LemonExplosive/Light-Materials-Test-Rig/LMTRPhotos/20240612_171728.jpg

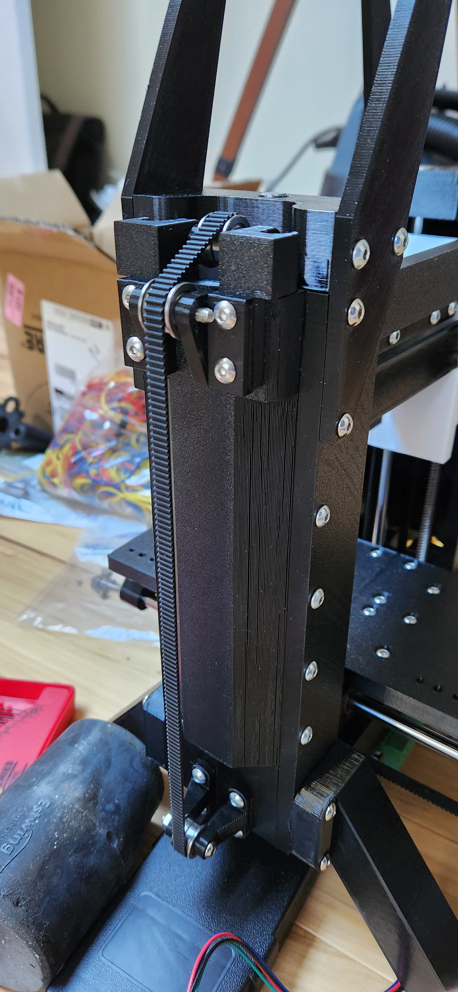
LMTRPhotos/20240612_171728.jpg
