LemonExplosive/Light-Materials-Test-Rig/LMTRPhotos/20240923_194150.jpg

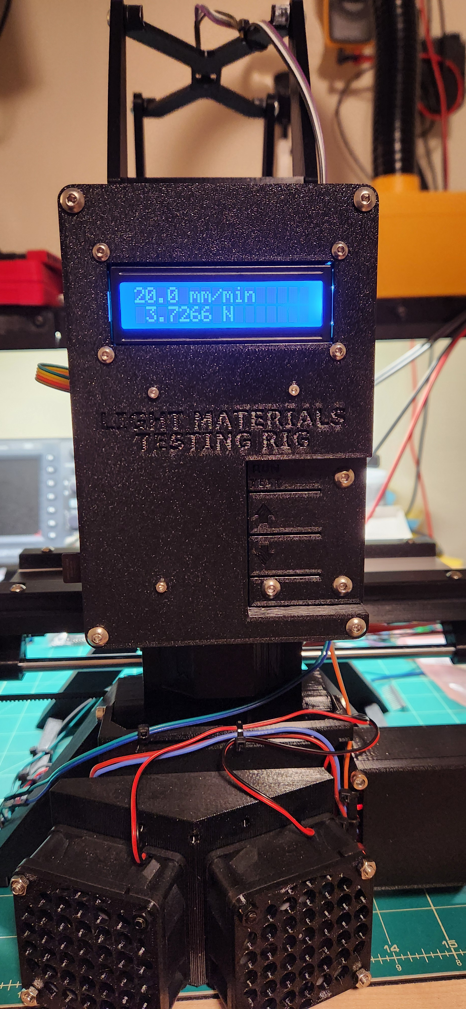
LMTRPhotos/20240923_194150.jpg
