LemonExplosive/Light-Materials-Test-Rig/LMTRPhotos/20240528_114817.jpg

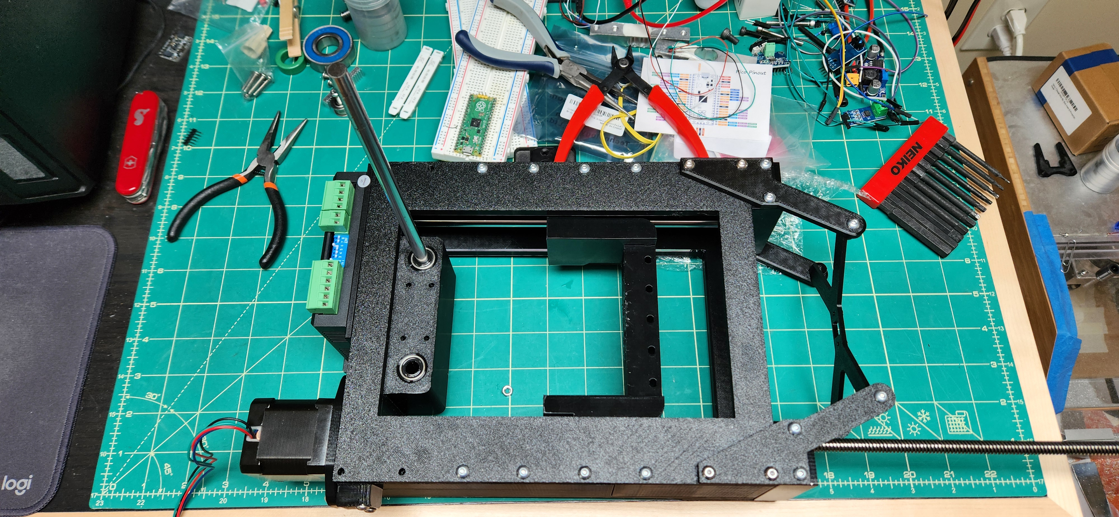
LMTRPhotos/20240528_114817.jpg
