LemonExplosive/Light-Materials-Test-Rig/LMTRPhotos/20240528_114821.jpg

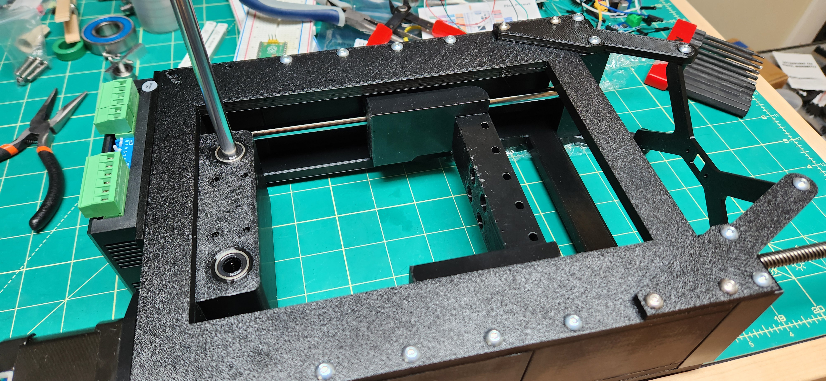
LMTRPhotos/20240528_114821.jpg
