LemonExplosive/Light-Materials-Test-Rig/LMTRPhotos/20240528_114832.jpg

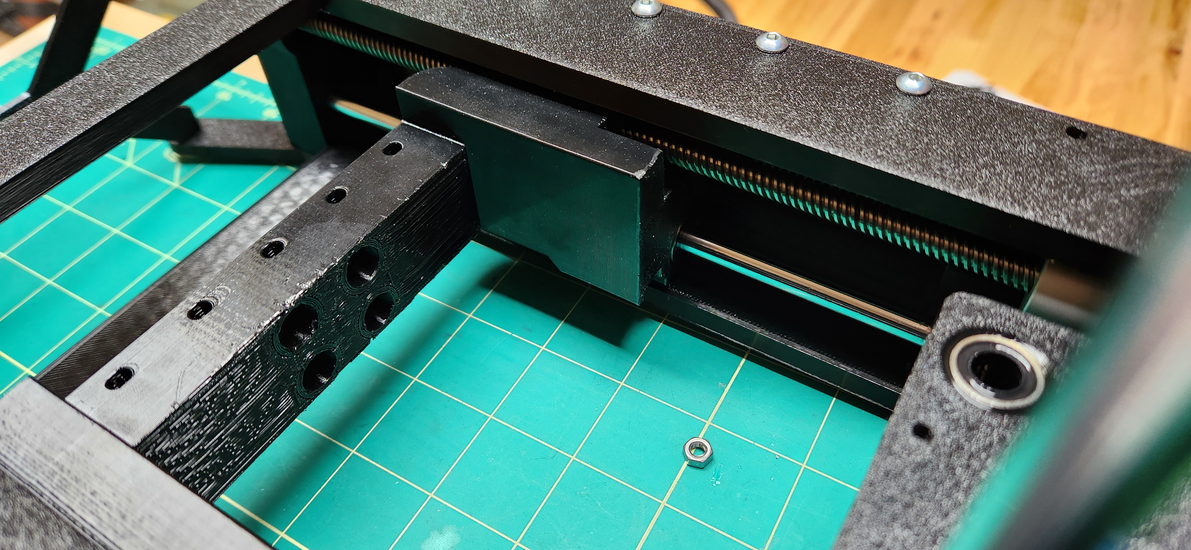
LMTRPhotos/20240528_114832.jpg
