LemonExplosive/Light-Materials-Test-Rig/LMTRPhotos/20240528_114836.jpg

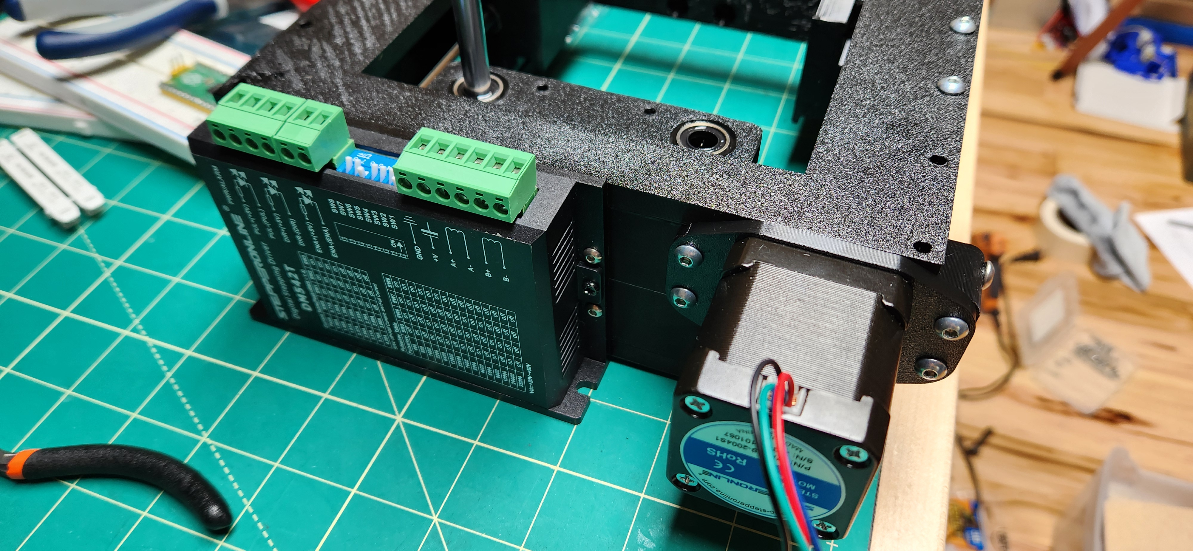
LMTRPhotos/20240528_114836.jpg
