LemonExplosive/Light-Materials-Test-Rig/LMTRPhotos/20240528_114841.jpg

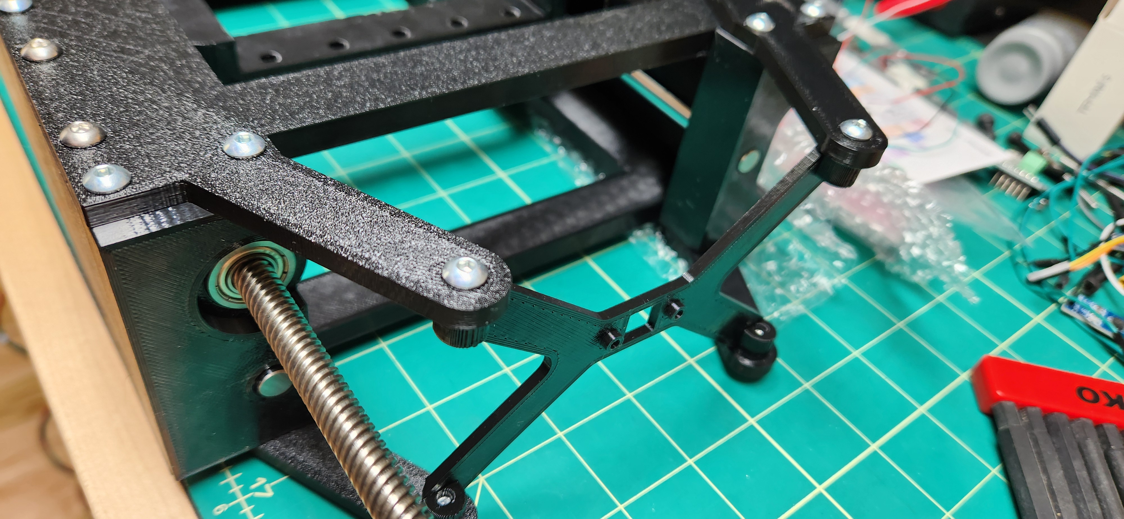
LMTRPhotos/20240528_114841.jpg
