LemonExplosive/Light-Materials-Test-Rig/LMTRPhotos/20240529_230357.jpg

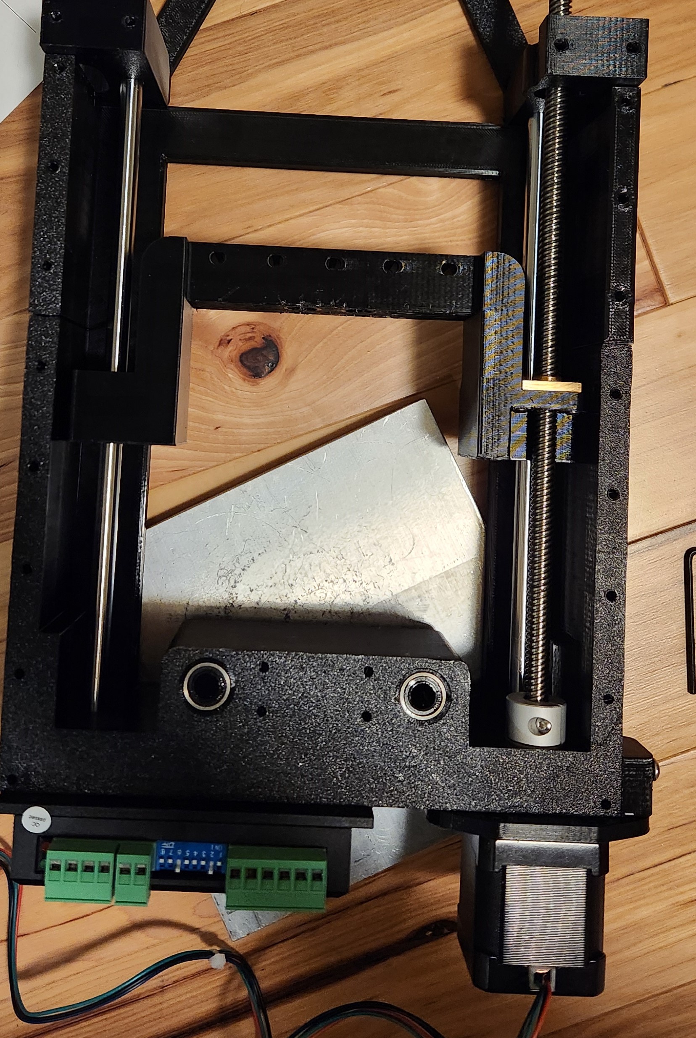
LMTRPhotos/20240529_230357.jpg
