LemonExplosive/Light-Materials-Test-Rig/LMTRPhotos/20240530_120917.jpg

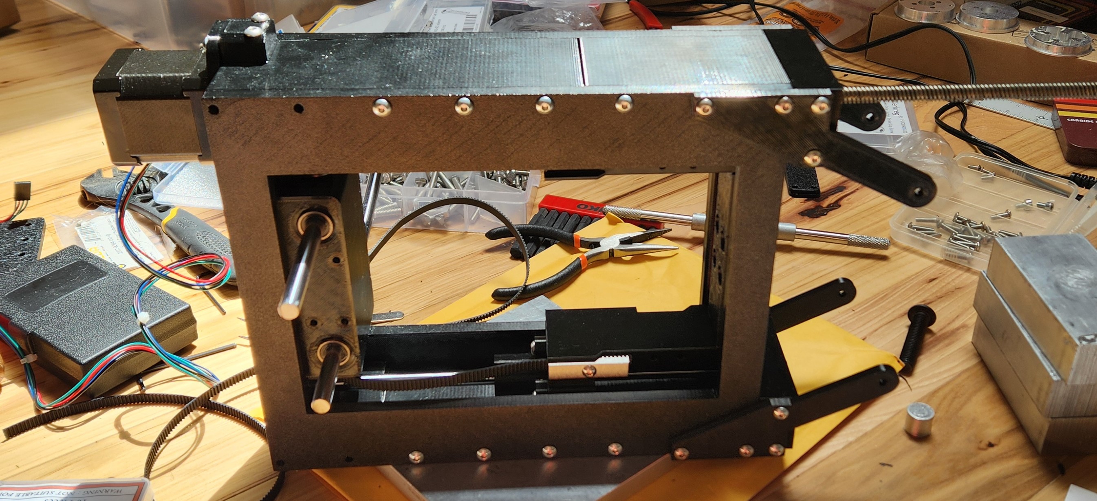
LMTRPhotos/20240530_120917.jpg
