LemonExplosive/Light-Materials-Test-Rig/LMTRPhotos/20240601_184201.jpg

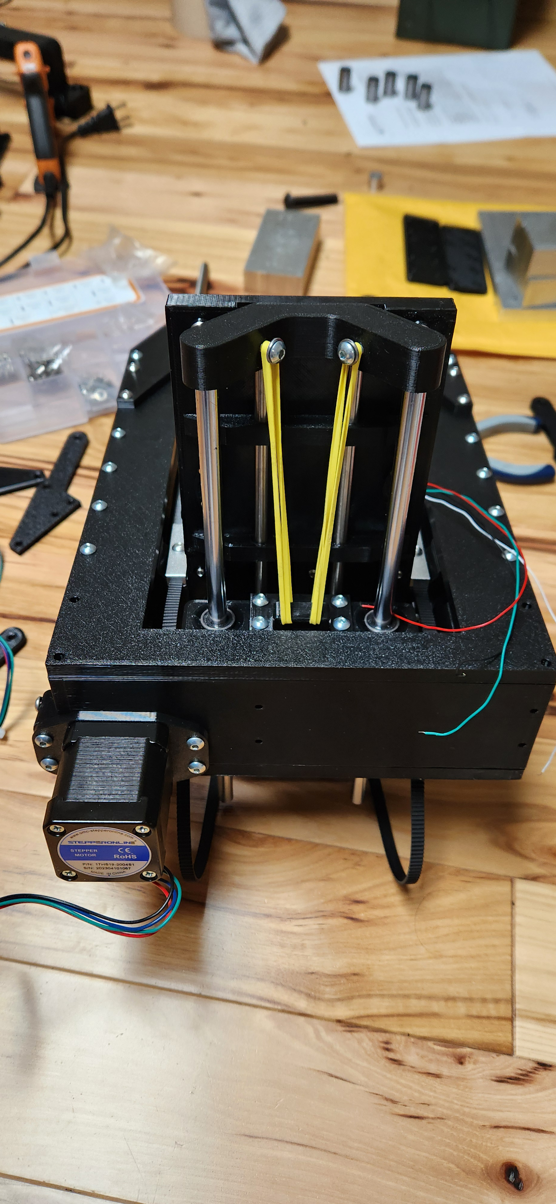
LMTRPhotos/20240601_184201.jpg
