LemonExplosive/Light-Materials-Test-Rig/LMTRPhotos/20240601_184204.jpg

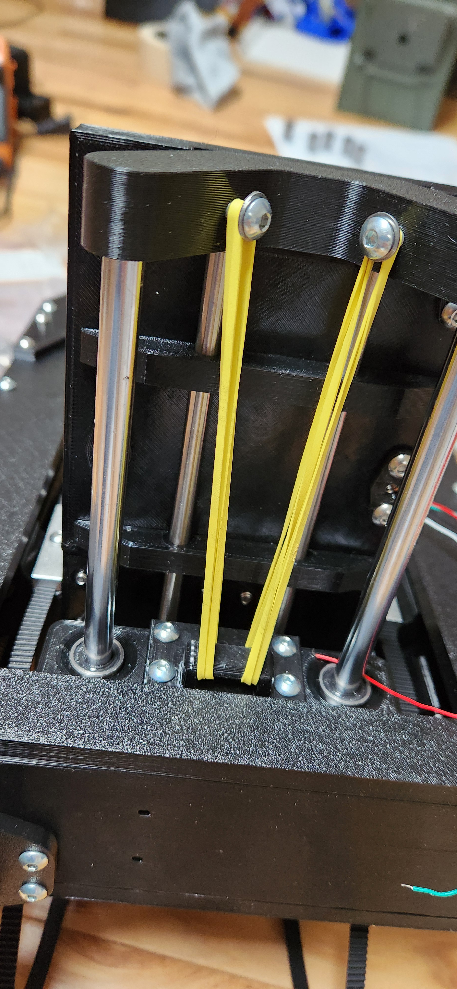
LMTRPhotos/20240601_184204.jpg
