LemonExplosive/Light-Materials-Test-Rig/LMTRPhotos/20240601_184206.jpg

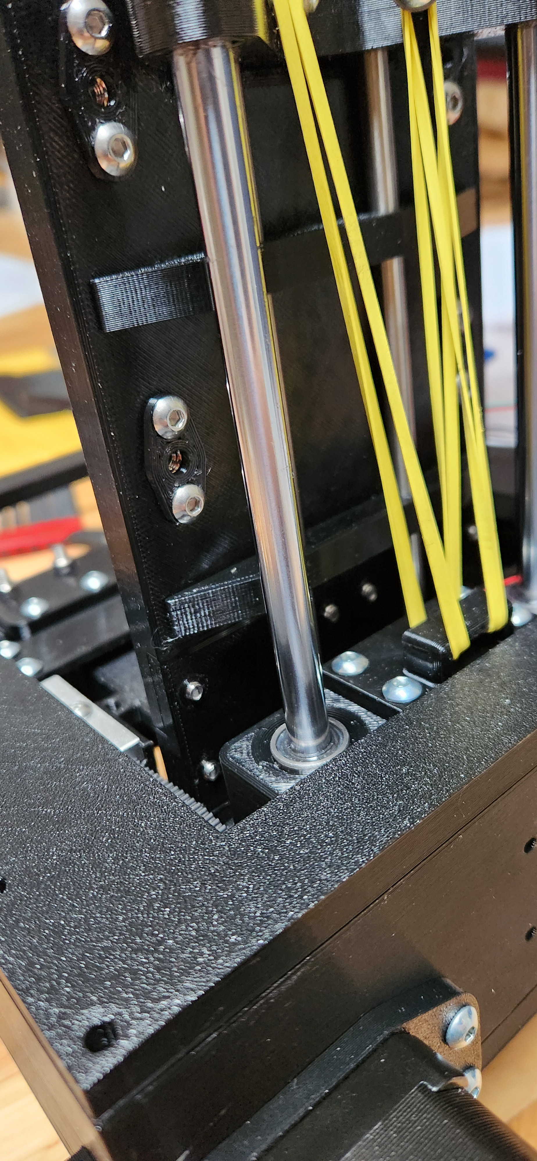
LMTRPhotos/20240601_184206.jpg
