LemonExplosive/Light-Materials-Test-Rig/LMTRPhotos/20240612_171720.jpg

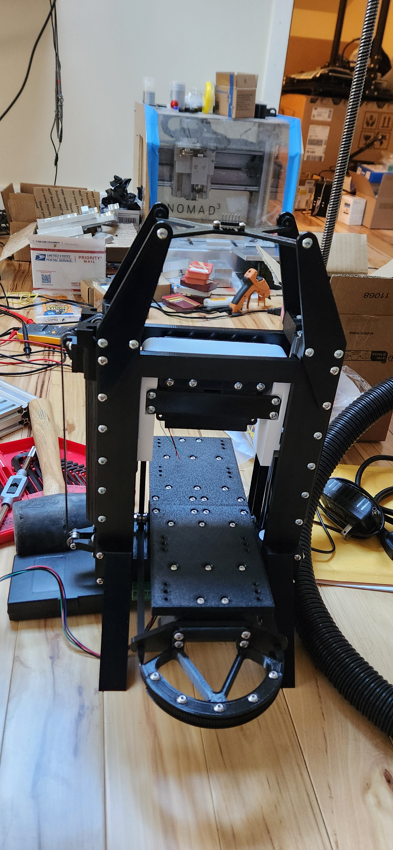
LMTRPhotos/20240612_171720.jpg
