LemonExplosive/Light-Materials-Test-Rig/LMTRPhotos/20240612_171732.jpg

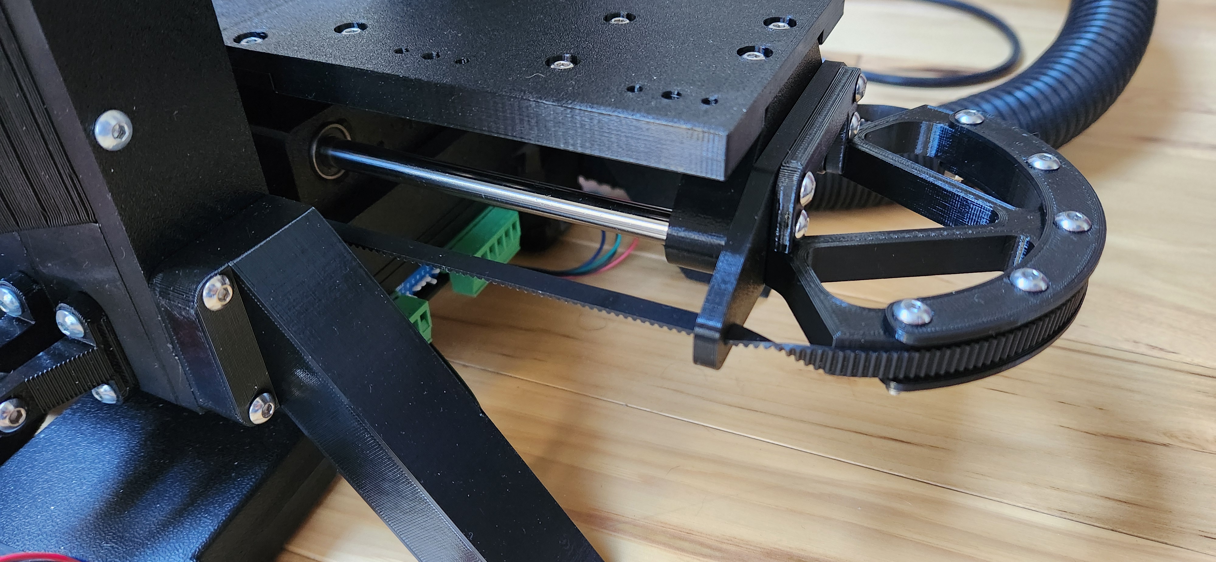
LMTRPhotos/20240612_171732.jpg
