LemonExplosive/Light-Materials-Test-Rig/LMTRPhotos/20240612_171736.jpg

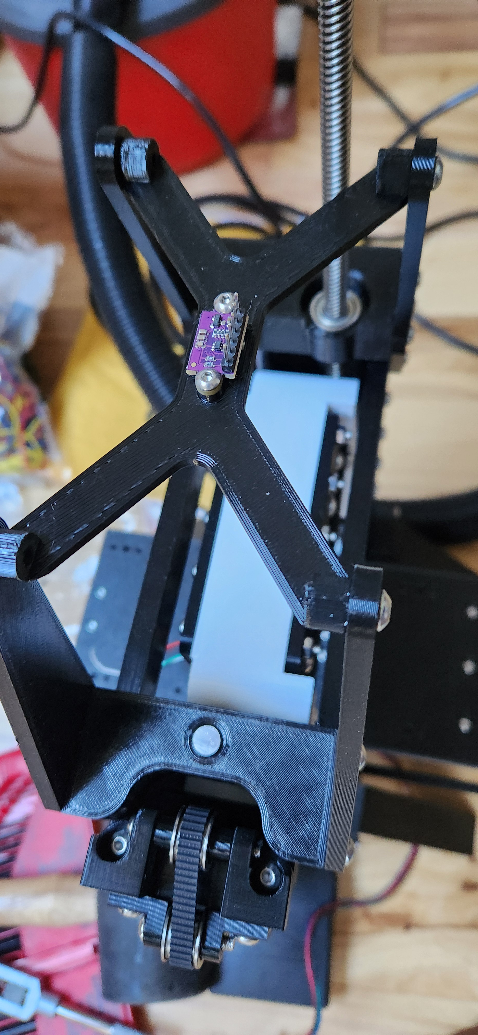
LMTRPhotos/20240612_171736.jpg
