LemonExplosive/Light-Materials-Test-Rig/LMTRPhotos/20240612_171740.jpg

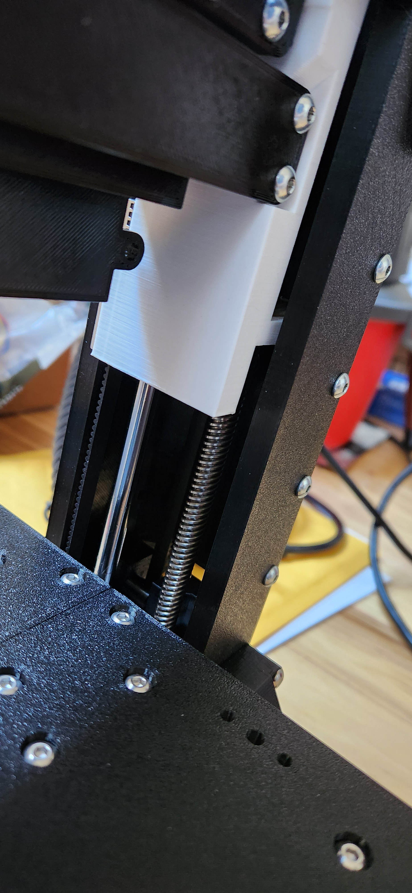
LMTRPhotos/20240612_171740.jpg
