LemonExplosive/Light-Materials-Test-Rig/LMTRPhotos/20240612_171745.jpg

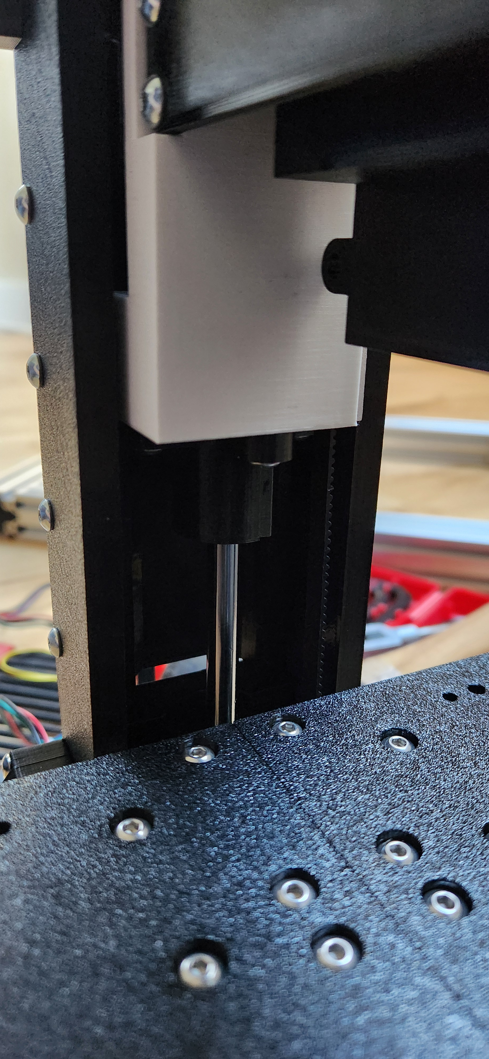
LMTRPhotos/20240612_171745.jpg
