LemonExplosive/Light-Materials-Test-Rig/LMTRPhotos/20240612_171805.jpg

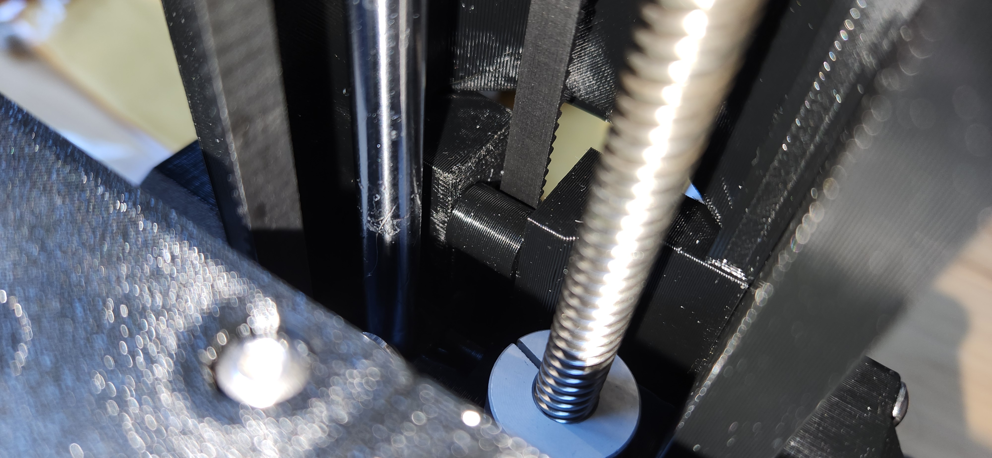
LMTRPhotos/20240612_171805.jpg
