LemonExplosive/Light-Materials-Test-Rig/LMTRPhotos/20240612_175203.jpg

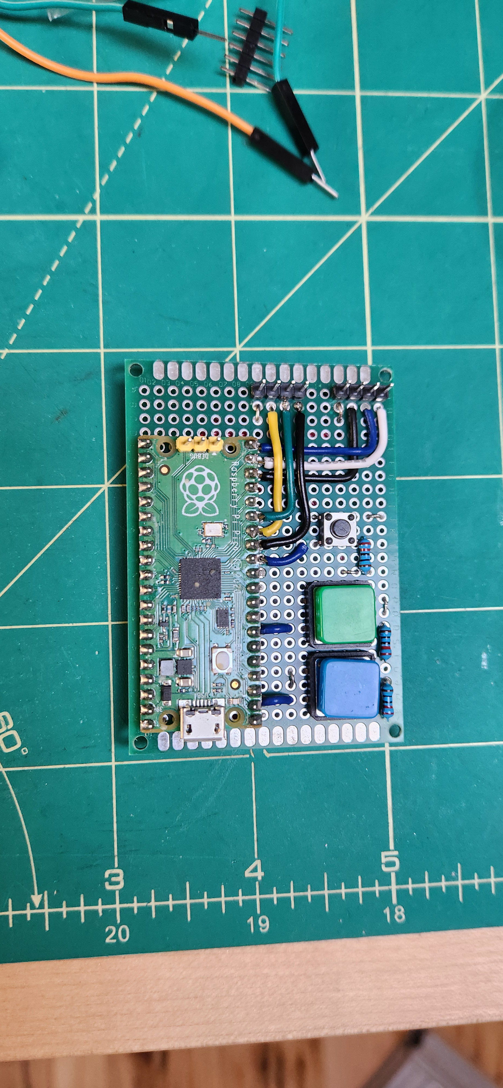
LMTRPhotos/20240612_175203.jpg
