LemonExplosive/Light-Materials-Test-Rig/LMTRPhotos/20240612_175207.jpg

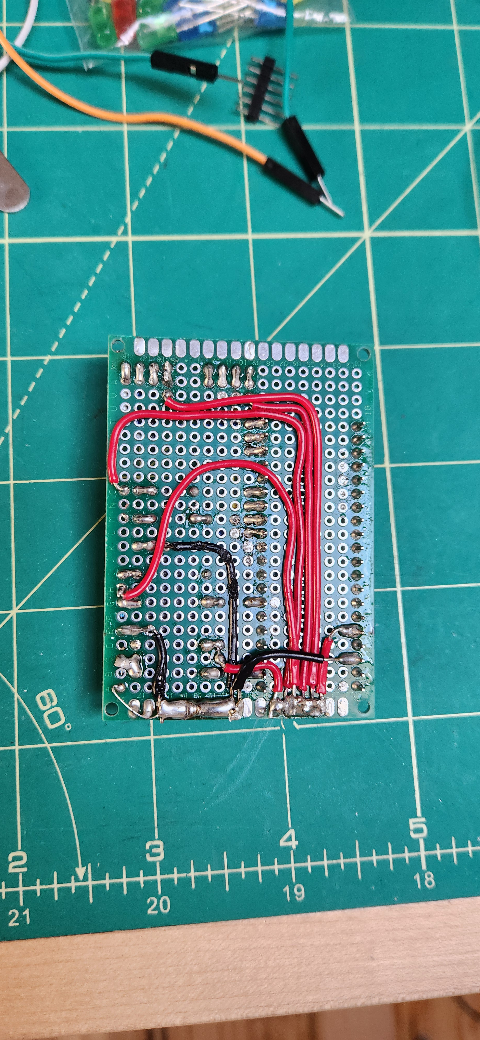
LMTRPhotos/20240612_175207.jpg
