LemonExplosive/Light-Materials-Test-Rig/LMTRPhotos/20240701_200305.jpg

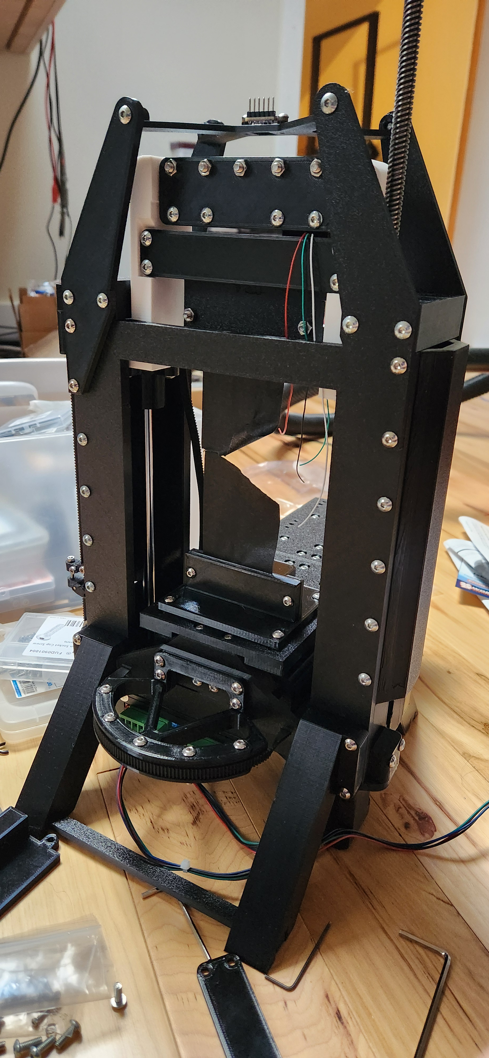
LMTRPhotos/20240701_200305.jpg
