LemonExplosive/Light-Materials-Test-Rig/LMTRPhotos/20240709_172404.jpg

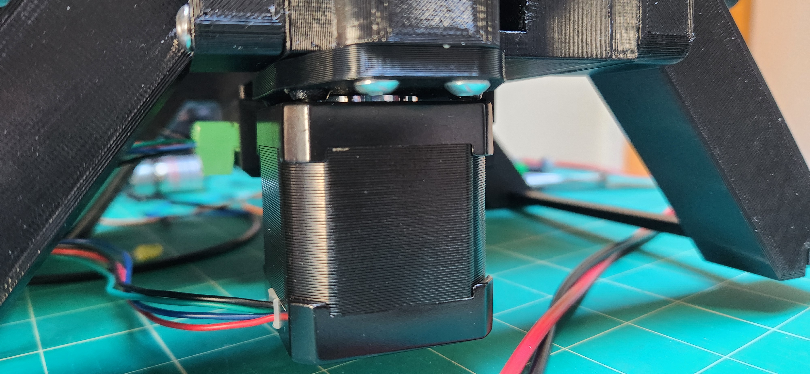
LMTRPhotos/20240709_172404.jpg
