LemonExplosive/Light-Materials-Test-Rig/LMTRPhotos/20240709_172408.jpg

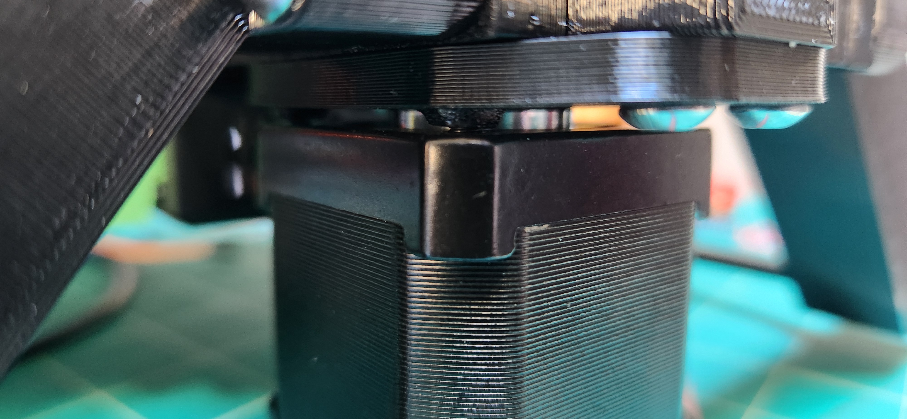
LMTRPhotos/20240709_172408.jpg
