LemonExplosive/Light-Materials-Test-Rig/LMTRPhotos/20240717_140434.jpg

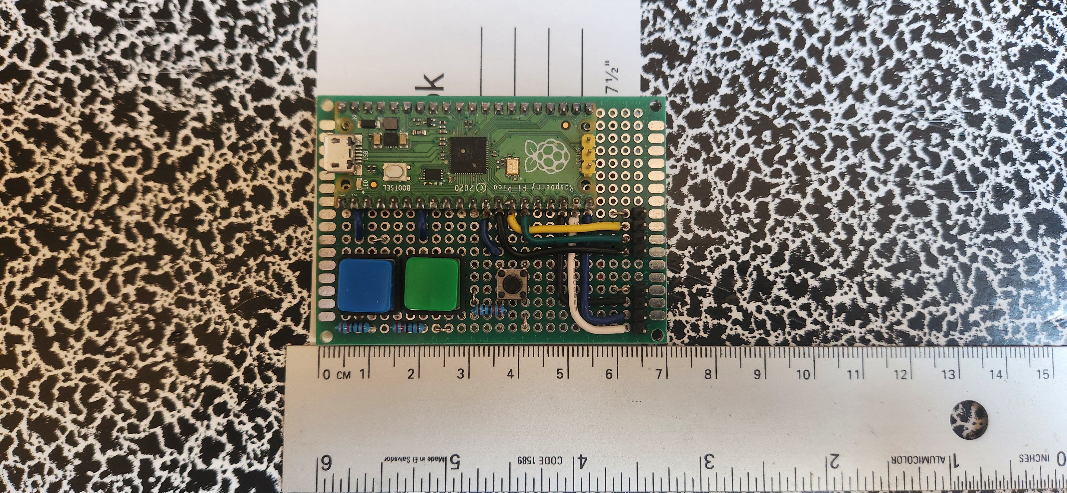
LMTRPhotos/20240717_140434.jpg
