LemonExplosive/Light-Materials-Test-Rig/LMTRPhotos/20240804_115958.jpg

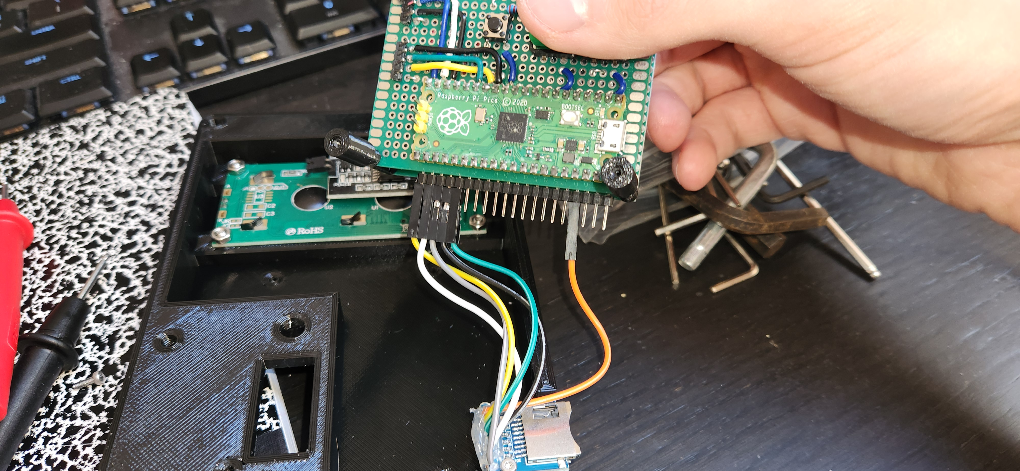
LMTRPhotos/20240804_115958.jpg
