LemonExplosive/Light-Materials-Test-Rig/LMTRPhotos/20240804_122026.jpg

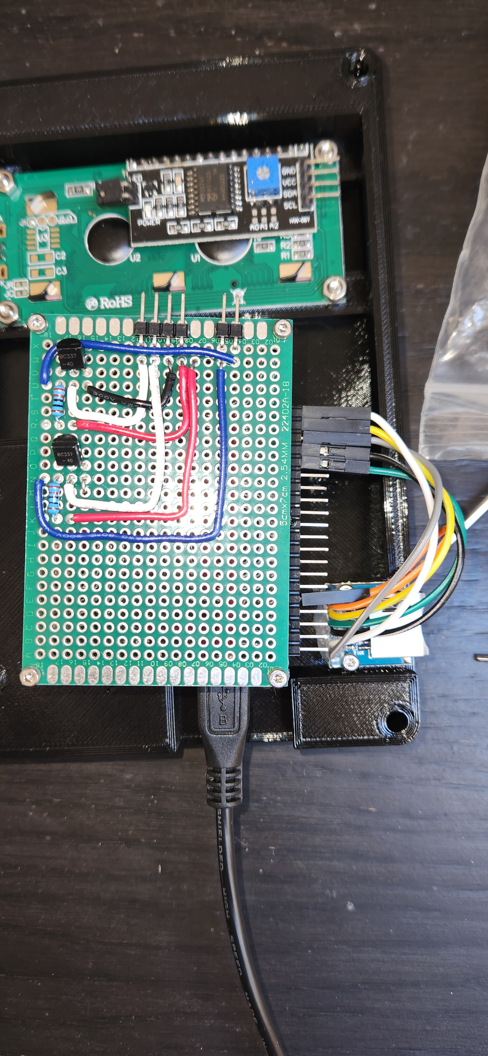
LMTRPhotos/20240804_122026.jpg
