LemonExplosive/Light-Materials-Test-Rig/LMTRPhotos/20240804_124502.jpg

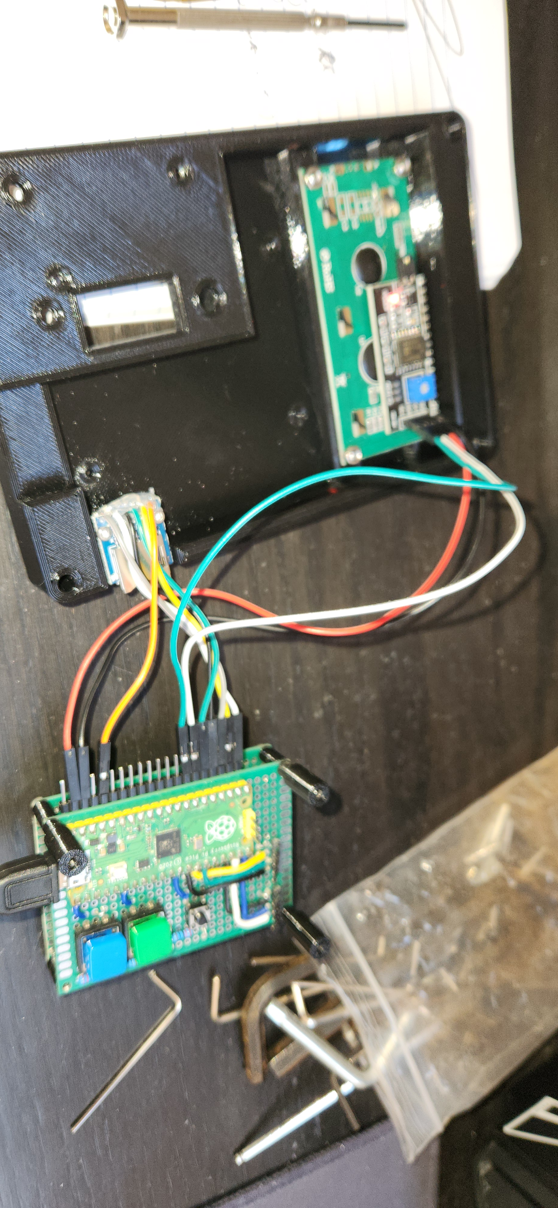
LMTRPhotos/20240804_124502.jpg
