LemonExplosive/Light-Materials-Test-Rig/LMTRPhotos/20240804_124520.jpg

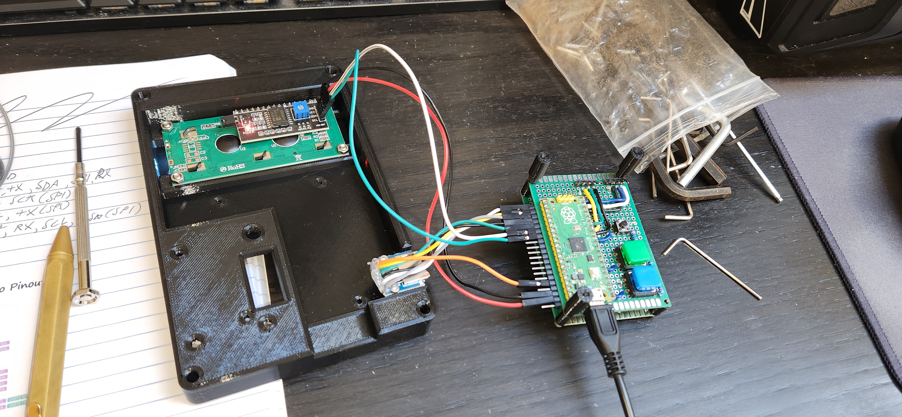
LMTRPhotos/20240804_124520.jpg
