LemonExplosive/Light-Materials-Test-Rig/LMTRPhotos/20240804_124527.jpg

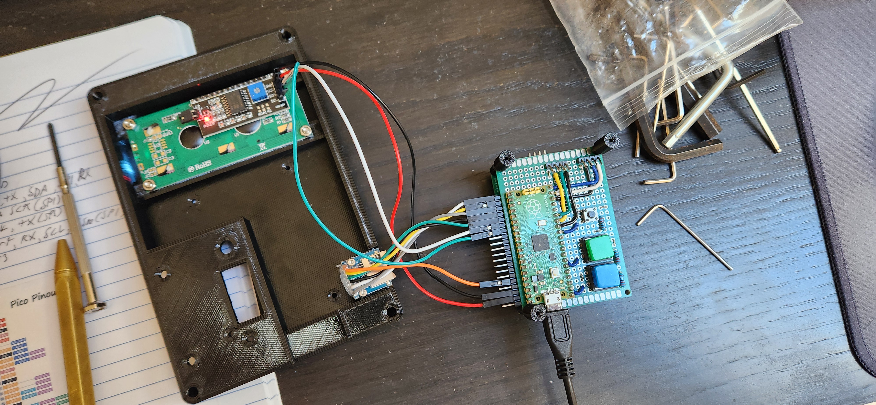
LMTRPhotos/20240804_124527.jpg
