LemonExplosive/Light-Materials-Test-Rig/LMTRPhotos/20240809_143550.jpg

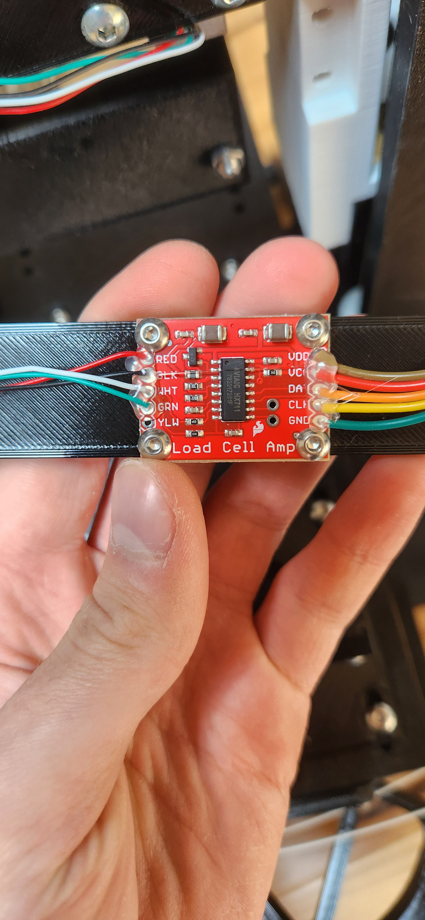
LMTRPhotos/20240809_143550.jpg
