LemonExplosive/Light-Materials-Test-Rig/LMTRPhotos/20240809_150119.jpg

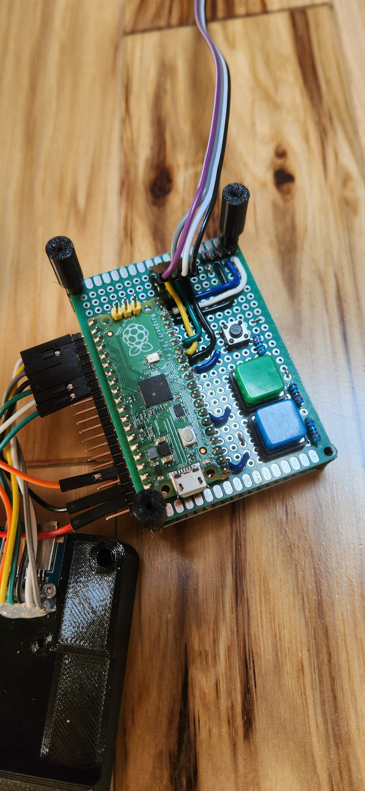
LMTRPhotos/20240809_150119.jpg
