LemonExplosive/Light-Materials-Test-Rig/LMTRPhotos/20240809_150322.jpg

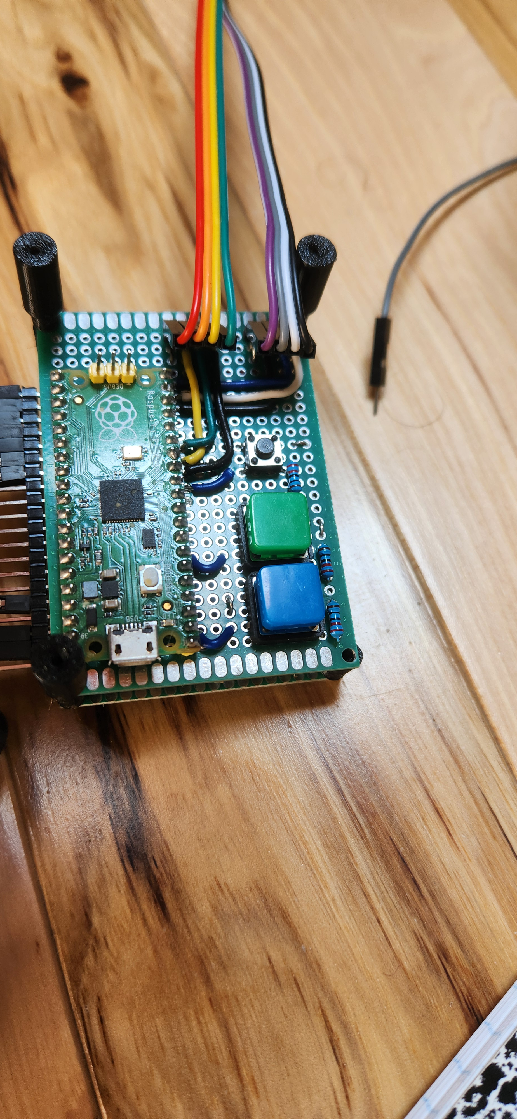
LMTRPhotos/20240809_150322.jpg
