LemonExplosive/Light-Materials-Test-Rig/LMTRPhotos/20240824_185719.jpg

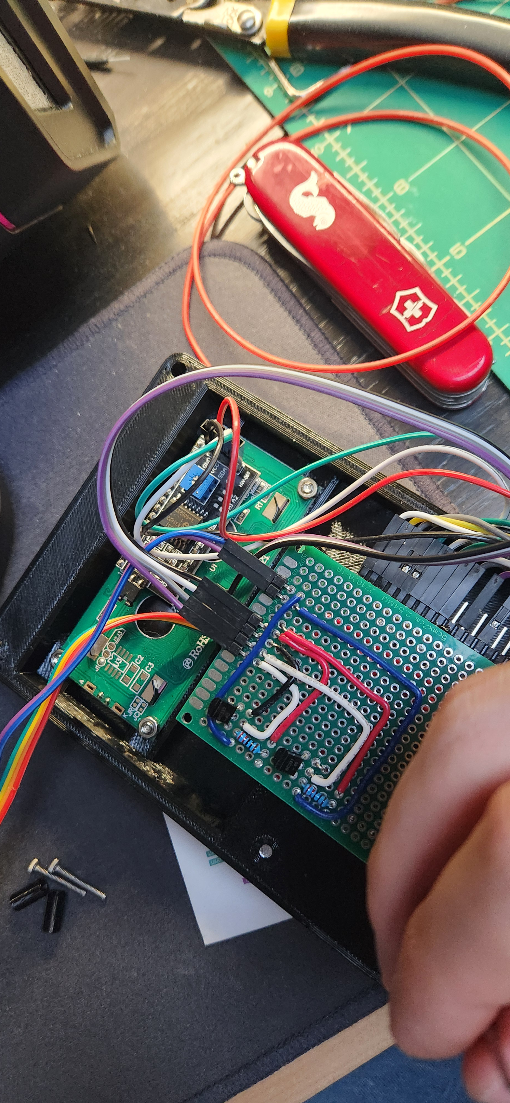
LMTRPhotos/20240824_185719.jpg
