LemonExplosive/Light-Materials-Test-Rig/LMTRPhotos/20240825_003141.jpg

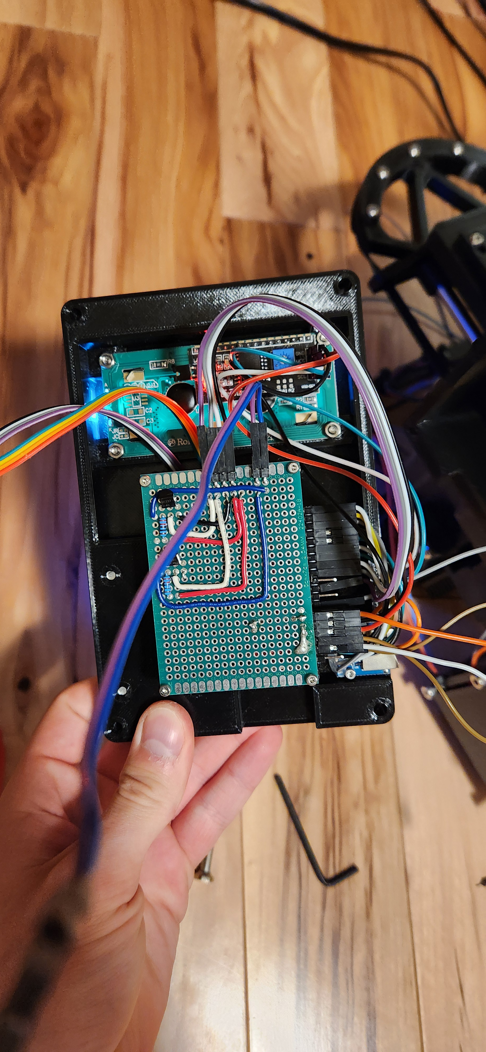
LMTRPhotos/20240825_003141.jpg
