LemonExplosive/Light-Materials-Test-Rig/LMTRPhotos/20240919_175427.jpg

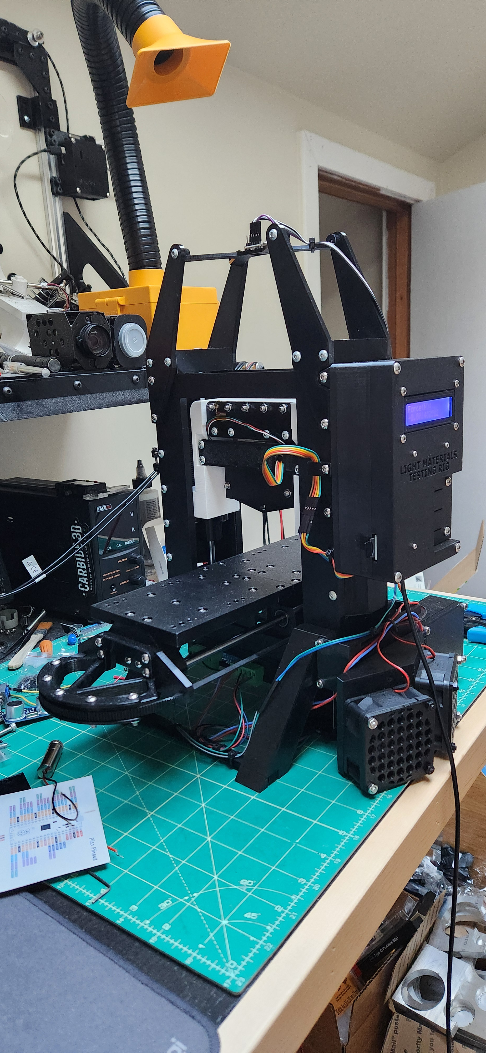
LMTRPhotos/20240919_175427.jpg
