LemonExplosive/Light-Materials-Test-Rig/LMTRPhotos/20240922_164223.jpg

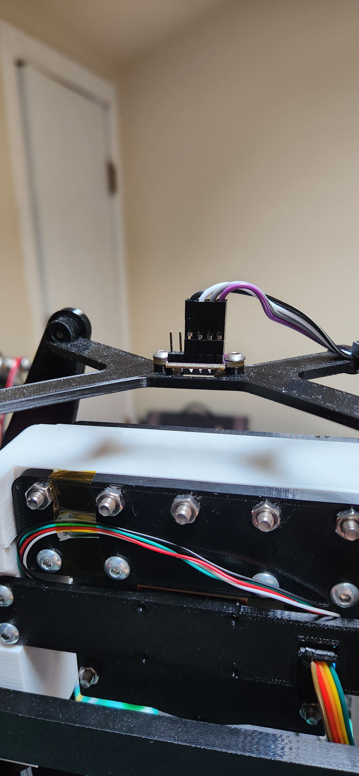
LMTRPhotos/20240922_164223.jpg
