LemonExplosive/Light-Materials-Test-Rig/LMTRPhotos/20240923_194141.jpg

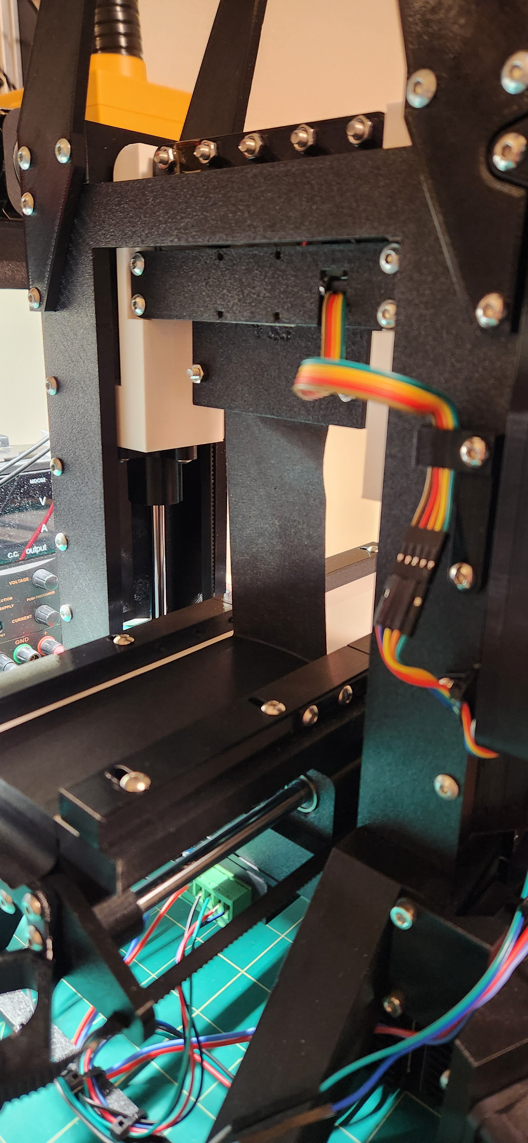
LMTRPhotos/20240923_194141.jpg
