LemonExplosive/Light-Materials-Test-Rig/LMTRPhotos/20240923_194143.jpg

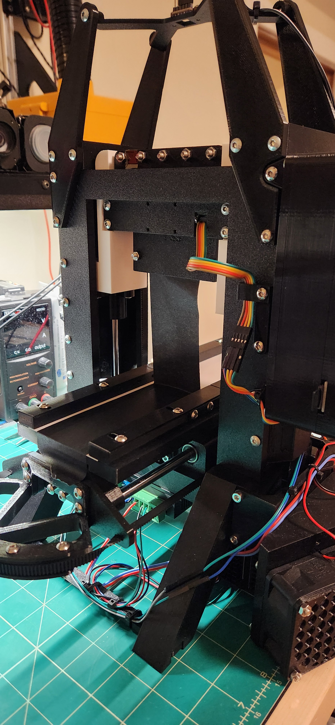
LMTRPhotos/20240923_194143.jpg
