LemonExplosive/Light-Materials-Test-Rig/Machine.PNG

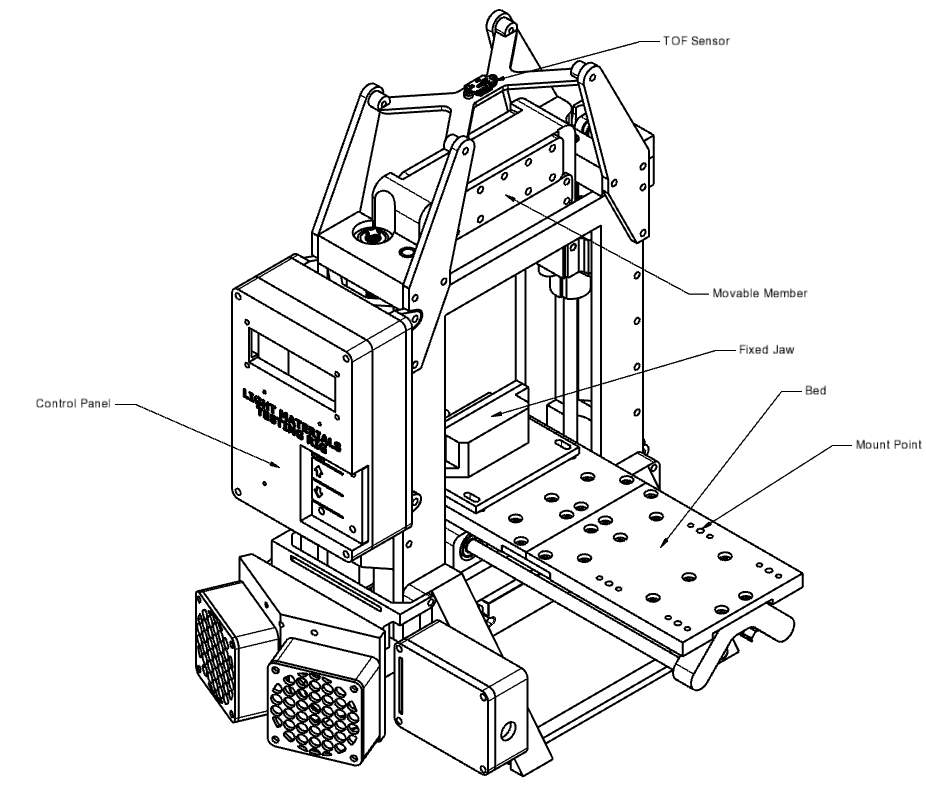
Machine.PNG
