LemonExplosive/Light-Materials-Test-Rig/MainHardware/Clamp Tie.stp

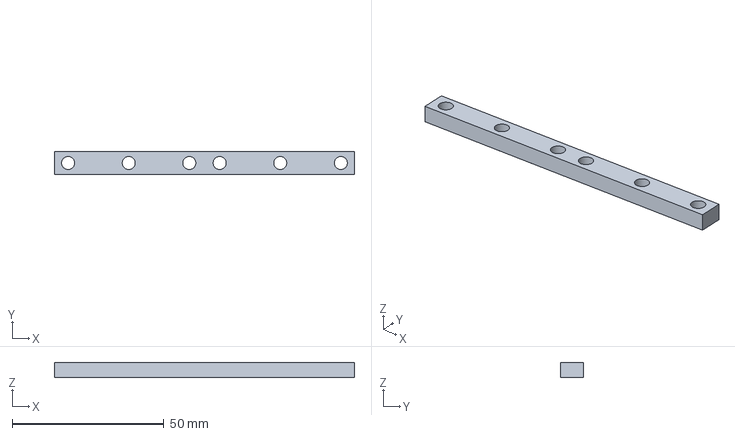
[picture p40: CAD file, 2024-10-11]
MainHardware/Clamp Tie.stp
99.0 x 7.50 x 5.00 mm
