LemonExplosive/Light-Materials-Test-Rig/MainHardware/Bed Clamp.stp

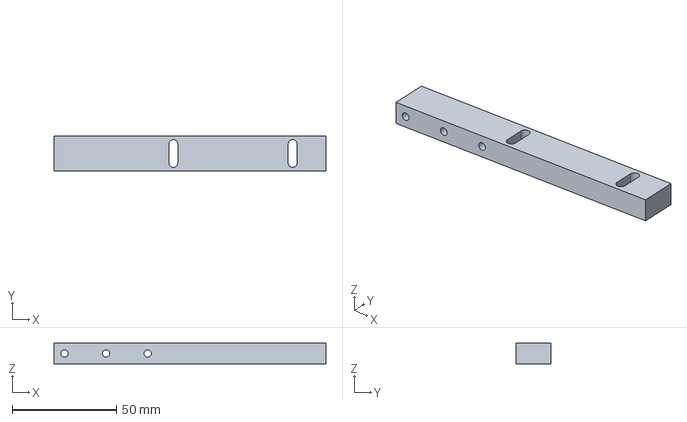
[picture p41: CAD file, 2024-10-11]
MainHardware/Bed Clamp.stp
130.5 x 17.0 x 10.0 mm
