LemonExplosive/Light-Materials-Test-Rig/PeelTest.csv

Force(N) | Distance(mm) | Time(ms)
0.001296461 | 124 | 259
0.001316541 | 124 | 306
0.001085613 | 124 | 398
0.001617752 | 124 | 493
0.005021431 | 120 | 584
0.0109352 | 128 | 676
0.02079483 | 122 | 769
0.03880722 | 124 | 862
0.06133778 | 125 | 954
0.08323579 | 124 | 1047
0.1062784 | 124 | 1159
0.1330359 | 125 | 1232
0.1614401 | 123 | 1330
0.1908985 | 123 | 1417
0.2219131 | 126 | 1510
0.2558496 | 125 | 1603
0.2928784 | 121 | 1695
0.3319755 | 122 | 1788
0.3739241 | 122 | 1881
0.4164048 | 125 | 1973
0.4575 | 126 | 2066
0.4980329 | 124 | 2177
0.5386763 | 124 | 2251
0.5809462 | 123 | 2344
0.623457 | 121 | 2437
0.6680763 | 125 | 2529
0.7217922 | 125 | 2622
0.780468 | 120 | 2715
0.8432905 | 125 | 2807
0.9099986 | 123 | 2902
0.9753412 | 125 | 2992
1.043304 | 123 | 3085
1.114601 | 124 | 3196
1.190988 | 123 | 3270
1.269644 | 122 | 3363
1.346935 | 124 | 3456
1.426896 | 122 | 3548
1.508394 | 125 | 3641
1.591558 | 122 | 3737
1.677021 | 123 | 3826
1.763399 | 122 | 3919
1.857356 | 123 | 4011
1.956816 | 121 | 4104
2.052069 | 126 | 4215
2.144821 | 121 | 4289
2.232002 | 119 | 4382
2.317335 | 122 | 4475
2.408381 | 123 | 4572
2.503563 | 119 | 4660
2.609951 | 121 | 4753
2.716981 | 121 | 4845
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
