LemonExplosive/Light-Materials-Test-Rig/LoadCellNewtonConversion/PullTest8.csv

Force(N)
204664
204615
204606
204657
204657
204676
204641
204598
204637
204654
204670
204680
204659
204656
204667
204674
204696
204660
204610
204634
204656
204660
204648
204670
204656
204647
204659
204678
204650
204597
204653
204659
204662
204655
204649
204689
204698
204690
204681
204652
204671
204686
204642
204684
204679
204646
204614
204612
204629
204612
204607
204619
204622
204597
204646
204674
204633
204646
204654
204675
204660
204673
204647
204681
204696
204671
204646
204683
204688
204676
204683
204668
204662
204646
204672
204653
204651
204654
204605
204626
204695
204670
204629
204621
204659
204680
204650
204641
204643
204625
204634
204669
204680
204668
204689
204688
204636
204607
204618
204624
204632
204626
204651
204654
204720
204690
204638
204657
204636
204643
204642
204625
204619
204612
204616
204652
204710
204671
204671
204704
204673
204655
204627
204609
204669
204645
204617
204639
204631
204652
204659
204694
204657
204657
204666
204663
204691
204691
204680
204637
204636
204655
204643
204628
204647
204635
204669
204681
204676
204661
204611
204647
204690
204668
204684
204648
204623
204668
204682
204655
204628
204626
204648
204689
204694
204690
204651
204647
204693
204682
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
