LemonExplosive/Light-Materials-Test-Rig/LoadCellCalibrationASTM-E4/Decade1/PullTest0.csv

Force(N)
204457
204452
204489
204469
204417
204407
204439
204472
204448
204431
204419
204420
204374
204357
204402
204438
204446
204448
204440
204419
204426
204468
204433
204370
204444
204447
204428
204447
204446
204427
204423
204438
204429
204426
204397
204408
204448
204380
204383
204392
204398
204460
204402
204381
204430
204423
204465
204413
204414
204386
204393
204361
204409
204389
204380
204419
204445
204466
204453
204424
204410
204424
204427
204395
204383
204420
204403
204362
204371
204365
204422
204409
204429
204422
204427
204404
204394
204398
204418
204439
204444
204453
204447
204365
204353
204401
204413
204454
204411
204376
204399
204363
204382
204433
204451
204482
204453
204385
204446
204420
204378
204397
204407
204438
204409
204405
204401
204396
204426
204447
204475
204436
204397
204385
204399
204397
204417
204415
204409
204412
204387
204371
204341
204371
204416
204419
204436
204457
204420
204407
204417
204445
204416
204388
204480
204442
204386
204463
204408
204369
204389
204409
204365
204381
204438
204406
204373
204375
204417
204405
204412
204439
204401
204405
204439
204462
204417
204396
204406
204409
204386
204373
204389
204415
204459
204448
204414
204392
204404
204425
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
