LemonExplosive/Light-Materials-Test-Rig/LoadCellCalibrationASTM-E4/Decade1/PullTest1.csv

Force(N)
204081
204037
204118
204136
204174
204141
204107
204097
204150
204130
204098
204142
204123
204123
204082
204062
204080
204121
204154
204112
204072
204106
204100
204082
204092
204139
204180
204080
203987
204078
204162
204157
204141
204136
204133
204153
204123
204149
204122
204129
204144
204121
204078
204060
204090
204071
204068
204049
204125
204150
204110
204156
204133
204119
204156
204161
204115
204113
204104
204132
204164
204173
204164
204159
204147
204142
204115
204104
204099
204128
204094
204098
204111
204150
204174
204155
204120
204099
204131
204103
204136
204130
204115
204055
204086
204160
204131
204108
204104
204156
204120
204096
204104
204099
204081
204106
204130
204171
204184
204122
204060
204106
204181
204144
204121
204119
204117
204096
204126
204127
204136
204146
204105
204117
204131
204102
204138
204185
204145
204093
204142
204117
204120
204086
204056
204154
204165
204128
204108
204101
204119
204146
204117
204138
204115
204119
204141
204148
204123
204141
204148
204136
204158
204142
204142
204133
204099
204105
204095
204126
204104
204140
204071
204135
204164
204147
204097
204084
204071
204108
204128
204116
204117
204118
204106
204117
204150
204113
204149
204122
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
