LemonExplosive/Light-Materials-Test-Rig/LoadCellCalibrationASTM-E4/Decade1/PullTest2.csv

Force(N)
204069
204060
204037
204080
204108
204086
204079
204076
204106
204087
204059
204073
204062
204071
204076
204056
204079
204085
204092
204110
204029
204060
204142
204095
204117
204096
204092
204093
204101
204105
204014
204028
204052
204104
204133
204065
204033
204108
204133
204120
204102
204035
204057
204083
204131
204099
204065
204067
204119
204108
204033
204050
204067
204101
204102
204061
204039
204051
204099
204061
204053
204060
204078
204105
204069
204079
204121
204087
204104
204084
204082
204081
204071
204062
204072
204080
204026
204054
204144
204100
204100
204094
204078
204078
204068
204057
204085
204066
204041
204030
204092
204086
204065
204074
204096
204045
204034
204087
204063
204097
204105
204130
204081
204092
204081
204078
204040
204057
204100
204089
204096
204098
204068
204053
204054
204128
204102
204047
204056
204052
204055
204060
204076
204093
204053
204030
204033
204032
204081
204097
204069
204039
204049
204049
204057
204053
204080
204074
204084
204059
204079
204062
204082
204122
204087
203985
204028
204082
204050
204074
204062
204056
204031
204053
204090
204089
204116
204144
204118
204066
204100
204088
204054
204050
204057
204089
204071
204060
204033
204003
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
