LemonExplosive/Light-Materials-Test-Rig/LoadCellCalibrationASTM-E4/Decade1/PullTest3.csv

Force(N)
204074
204097
204081
204093
204045
204022
204027
204022
204057
204077
204079
204073
204023
204019
204003
204029
204070
204060
204078
204017
204010
204045
204048
204082
204059
204046
204044
204057
204041
204052
204049
204023
204045
204077
204038
204015
204038
204041
204075
204053
203999
204020
204031
204031
204012
204042
204063
204042
203987
204049
204116
204043
204046
204069
204083
204076
204046
204033
204034
204047
204063
204075
204061
204026
204040
204056
204049
204038
204041
204077
204090
204078
204051
204046
204033
204008
203994
204057
204055
204073
204067
204069
204075
204049
204034
204016
204006
204022
204026
204043
204043
204047
204041
204039
204048
204032
204025
204072
204083
204051
204003
204054
204053
204031
204022
204039
204066
204043
204028
204040
204038
204032
204034
204020
204011
204024
204044
204030
204014
204052
204075
204087
204083
204092
204014
204014
204066
204086
204119
204135
204070
204041
204011
204022
204069
204046
204018
204036
204043
204067
204034
204025
204044
204047
204067
204035
204088
204098
204081
204049
204025
204023
204061
204050
204062
204082
204087
204096
204062
204031
204042
204026
204053
204054
204037
204006
204080
204091
204078
204051
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
