LemonExplosive/Light-Materials-Test-Rig/LoadCellCalibrationASTM-E4/Decade1/PullTest4.csv

Force(N)
204036
203987
203927
203915
204011
204007
203991
203954
203972
203993
204009
203976
203985
203963
203942
203963
204012
203988
203981
203988
203961
203923
203983
204004
203967
203974
203972
203965
203947
203998
204015
203962
203988
204007
203973
203915
203929
203997
203994
203931
203950
203999
204020
203984
203982
204007
203965
203978
203972
203986
203965
203950
203989
204049
204001
203951
203910
203883
203962
204005
204003
203997
203985
203995
203988
203961
203946
203964
203951
203955
203971
203996
203975
203969
203978
204005
204002
203990
203944
203996
203986
203982
203968
203988
203960
203955
203946
203891
203913
203966
203994
203992
203966
203985
204002
203977
203941
203922
203939
203939
203948
203936
203937
203952
203987
203974
203976
204004
203980
203961
203974
203947
203946
204011
203951
204014
204002
203962
203961
204022
204029
203996
204010
203977
203987
204020
204005
204022
203964
203985
203970
203988
203990
203982
203968
203979
203988
203934
203957
203974
203932
203953
203920
203962
203984
203990
203989
204010
204009
203970
203921
203900
203947
203936
203921
203933
203979
204012
204001
204035
203983
203946
203960
203982
203949
203938
203957
203947
203966
203951
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
