LemonExplosive/Light-Materials-Test-Rig/LoadCellCalibrationASTM-E4/Decade2/PullTest0.csv

Force(N)
203888
203934
203957
203920
203930
203956
203935
203938
203951
203940
203935
203969
203976
203974
203953
203932
203966
203990
203968
203992
203987
203973
203942
203929
203937
203956
203940
203918
203943
203959
203960
203933
203933
203934
204002
203992
203931
203968
203987
203982
203965
203893
203929
203963
203942
203908
203901
203932
203928
203959
204000
203965
203931
203956
203979
203944
203924
203911
203911
203947
203950
203929
203960
204012
203999
203931
203892
203916
203963
203939
203929
203933
203989
203967
203926
203954
203990
203944
203931
203922
203920
203919
203961
203974
203952
203923
203938
203897
203925
203951
203939
203927
203930
203961
203919
203965
203946
203974
203962
203894
203896
203927
203897
203922
203929
203955
203934
203934
203927
203968
203980
203914
203904
203957
203939
203903
203921
203902
203905
203954
203960
203913
203906
203932
203923
203926
203949
203943
203960
203959
203992
203988
203949
203944
203948
203903
203859
203912
203906
203899
203915
203899
203930
203953
203961
203929
203875
203896
203922
203911
203885
203913
203924
203910
203917
203946
203937
203900
203906
203900
203925
203931
203961
203924
203916
203945
203934
203935
203903
203918
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
