LemonExplosive/Light-Materials-Test-Rig/OldCodeEvalutation/Calibration Report.pdf

Light Materials Testing Rig Drive Calibration Testing

John Lassen
9/19/2024

Abstract:
This report contains the test data from a load test device and its accuracy in its calibration of the movable member. On average the error in velocity is approximately 0.95% +/- 0.36% faster than the target velocity on average.

Introduction:
The objective of this experiment is to verify the calculations and methods used to set the velocity of the moving member in the load test rig.

Materials and Methods:
Materials:
- Stepper Motor
- VL53L0/1XV2 TOF Sensor
- Raspberry pi pico Microcontroller
- 8 mm pitch lead screw
- DM542T Stepper Driver


Methods:
- TOF Calibration:
- To calibrate the TOF sensor two distances were measured(with the sensor and a digital vernier caliper) from the TOF sensor mount to the movable member. Due to the TOF sensors low accuracy from a single measurement approximatley 5000 data points(outliers were removed) were gathered to achieve the most accurate value for both distances. The two measurements were subtracted(caliper measurements[84.95 mm +/- 0.01 mm and 63.75 mm +/- 0.01 mm] and TOF measurments[109.05 mm +/-0.04 mm and 89.76 mm +/- 0.04 mm]). From the difference in the two distances an error compensation value was created: 1.099 mm/TOF measurement.
- Velocity control formula:
◦

Screw Pitch∗60000ms/min
2∗Pulses Per Revolution∗Target Velocity (mm/min)
- The formula describes half the length of what the pulse should be(for the on and off period of the pulse, with an on and off or off and on being considered a complete pulse)
- Pulses Per Revolution:
- Amount of pulses per revolution can be modified through the dip switches on the DM542T Stepper Driver and was set to 400 pulses for this test
- Testing:
- There were a series of 6 tests that were conducted ranging from 1 mm/min to 50 mm/min. To run each test a target velocity was inputted and the movable member was placed approximately 100-120 mm away from the TOF sensor. Over the course of 120-2.5 min the movable member traversed its way until the TOF sensor read a return of 0 mm or less.

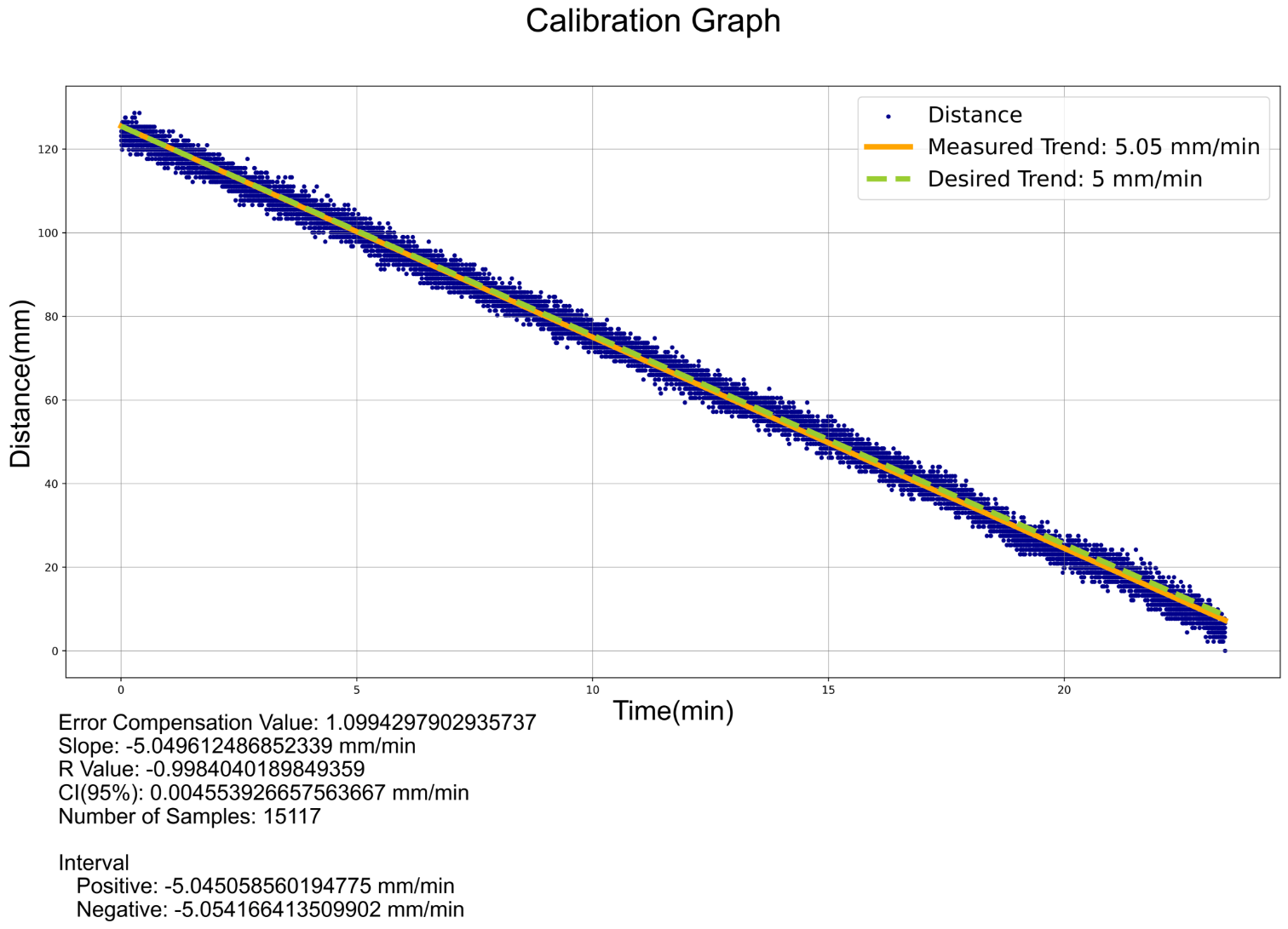
[picture p42: figure]

Results:
On average the
testing rig movable
member traversed
on average 0.95%
+/- 0.36% faster
than the target
velocity. The graph
shows what an
average error might
look like when
plotted.

Discussion:
It is currently unknown what is causing this overshoot in velocity, however, this could stem from the time.sleep_ms() function found in Micropython, since it requires an integer to function it may be that the delay input gets truncated shortening the delay just enough to induce this error in velocity.

Conclusion:
An unknown mechanism shortening the pulse length on the pico board causes a subtle increase in velocity in the range of 0.95% +/- 0.36% for most given velocity inputs.
