LemonExplosive/Light-Materials-Test-Rig/LoadCellCalibrationASTM-E4/Decade3/PullTest4.csv

Force(N)
203820
203792
203772
203798
203772
203759
203789
203769
203745
203768
203794
203806
203778
203765
203786
203779
203736
203735
203775
203781
203754
203778
203804
203728
203737
203751
203736
203756
203797
203778
203741
203788
203817
203801
203735
203733
203749
203731
203747
203763
203764
203723
203689
203674
203715
203714
203713
203722
203722
203723
203753
203709
203729
203749
203716
203705
203768
203798
203759
203767
203782
203776
203777
203740
203773
203773
203769
203766
203746
203724
203722
203754
203770
203742
203722
203727
203727
203738
203758
203759
203772
203780
203771
203787
203828
203821
203745
203682
203697
203733
203752
203794
203778
203737
203710
203731
203710
203771
203756
203762
203775
203782
203720
203689
203716
203729
203714
203670
203716
203736
203770
203775
203718
203749
203768
203755
203716
203712
203728
203754
203718
203718
203767
203795
203774
203735
203716
203807
203793
203766
203763
203761
203734
203707
203710
203723
203733
203769
203732
203699
203735
203766
203760
203745
203762
203772
203761
203734
203720
203705
203753
203779
203797
203795
203749
203724
203727
203728
203726
203721
203748
203738
203759
203756
203778
203784
203798
203845
203761
203754
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
