LemonExplosive/Light-Materials-Test-Rig/LoadCellCalibrationASTM-E4/Decade3/PullTest5.csv

Force(N)
203766
203736
203748
203771
203762
203707
203722
203803
203769
203733
203765
203771
203789
203765
203763
203720
203751
203746
203736
203736
203754
203771
203769
203789
203753
203761
203783
203767
203717
203714
203770
203773
203747
203744
203773
203731
203719
203696
203715
203767
203732
203738
203714
203723
203718
203723
203666
203666
203746
203745
203711
203709
203721
203731
203801
203770
203745
203756
203734
203722
203712
203701
203718
203744
203728
203729
203727
203713
203726
203728
203676
203713
203729
203781
203783
203768
203758
203721
203695
203679
203719
203750
203714
203684
203702
203696
203691
203746
203763
203707
203721
203734
203716
203707
203679
203671
203693
203714
203708
203737
203710
203698
203696
203722
203738
203717
203708
203710
203751
203751
203738
203702
203671
203708
203758
203760
203746
203698
203689
203705
203722
203729
203726
203731
203703
203745
203772
203737
203709
203757
203788
203720
203689
203730
203730
203725
203691
203713
203766
203755
203725
203730
203724
203681
203667
203650
203671
203706
203680
203710
203760
203731
203725
203732
203737
203746
203682
203690
203712
203711
203693
203681
203704
203691
203700
203706
203707
203729
203727
203723
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
