LemonExplosive/Light-Materials-Test-Rig/LiftActionCalibrationGraphs/5mm1.png

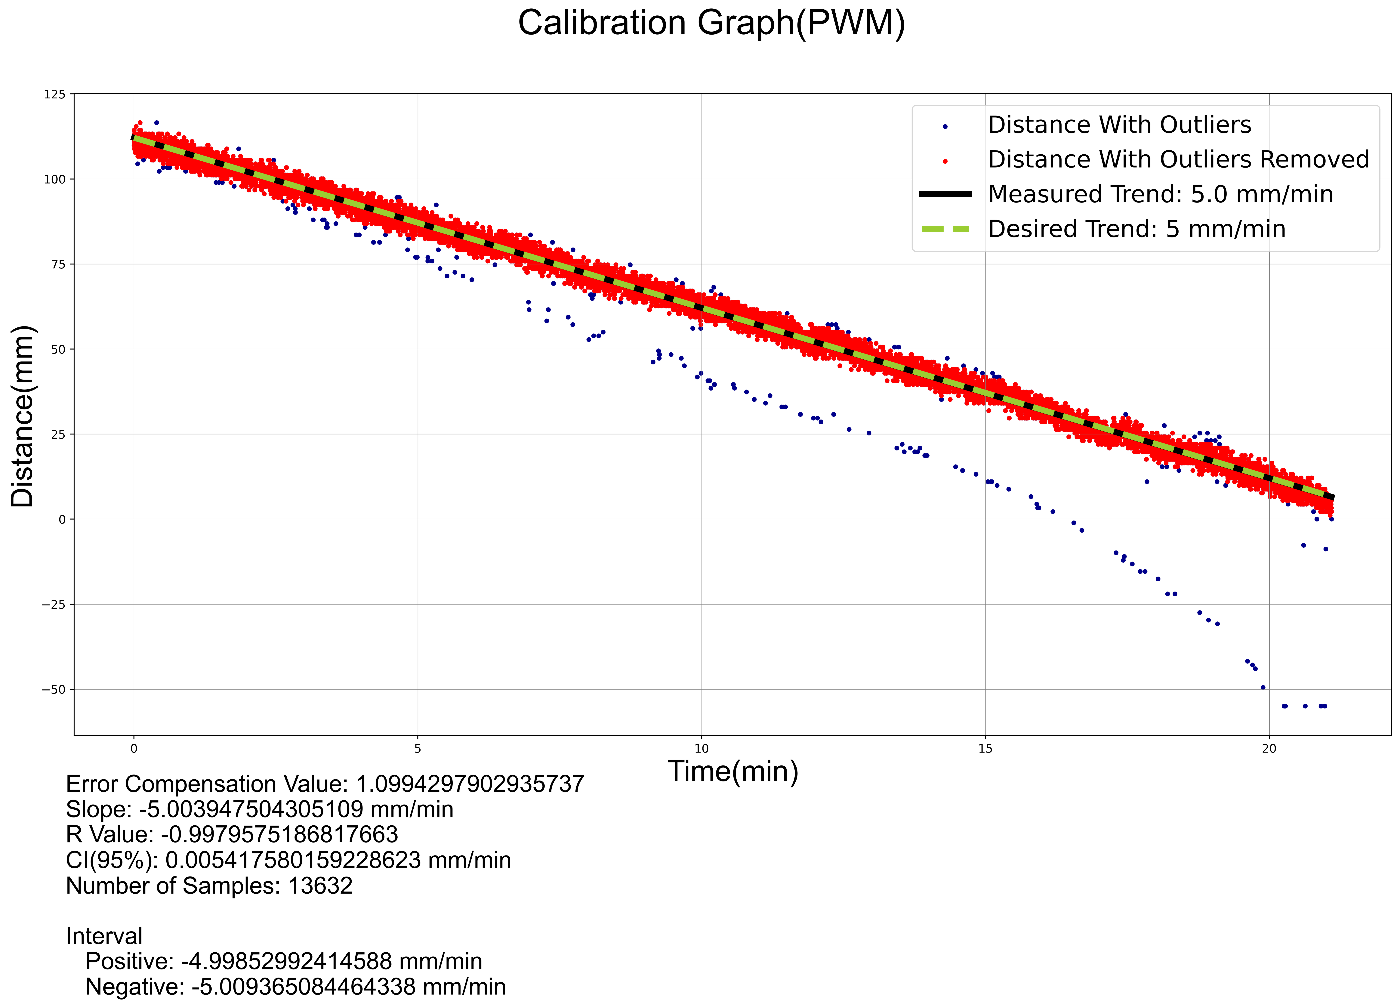
LiftActionCalibrationGraphs/5mm1.png
