LemonExplosive/Light-Materials-Test-Rig/LiftActionCalibrationGraphs/5mm2.png

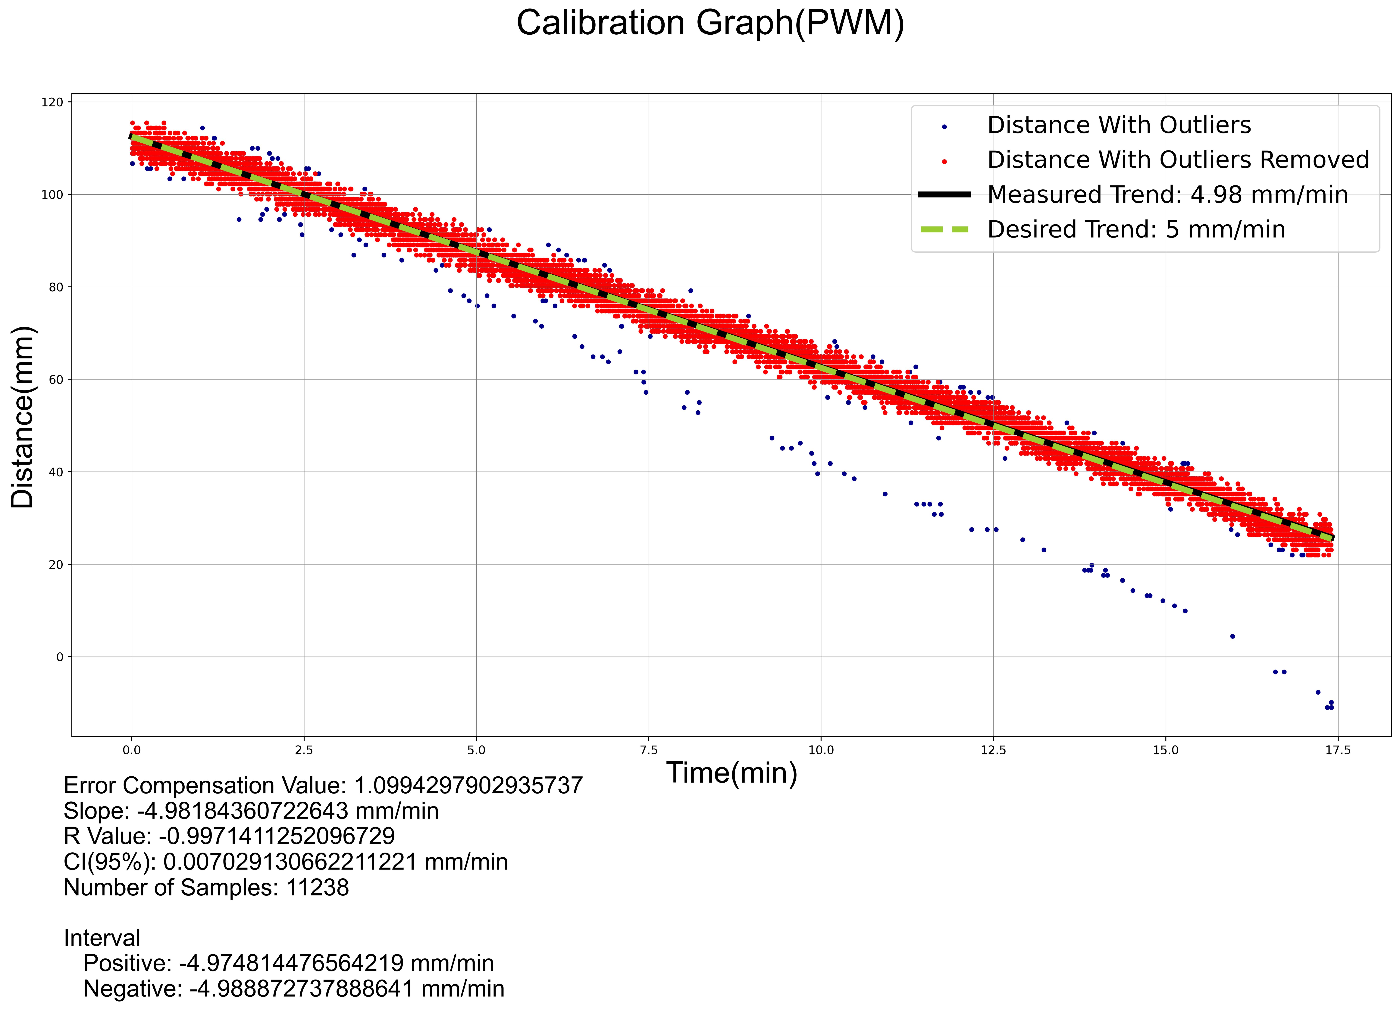
LiftActionCalibrationGraphs/5mm2.png
