LemonExplosive/Light-Materials-Test-Rig/LoadCellCalibrationASTM-E4/Figures/Figure 2024-10-09 174723.png

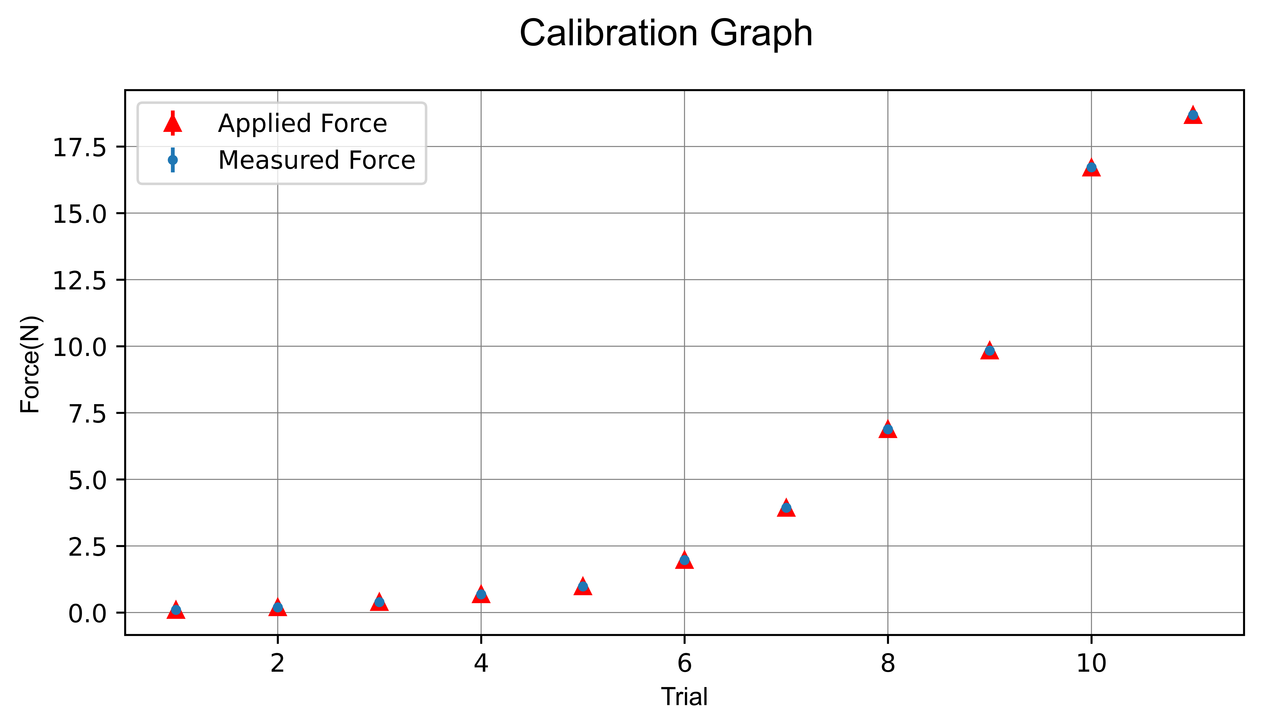
LoadCellCalibrationASTM-E4/Figures/Figure 2024-10-09 174723.png
